karlp/wifi-advent/pics-vids/IMG_20161207_011018.jpg

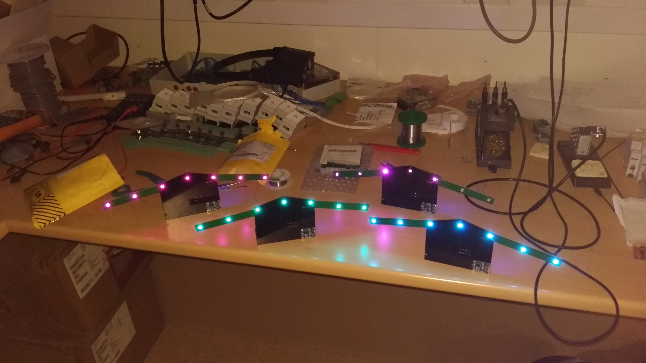
pics-vids/IMG_20161207_011018.jpg
