karlp/wifi-advent/hw/main-board-rev1d.sch

## EAGLE design hw/main-board-rev1d.sch (2016-11-26)

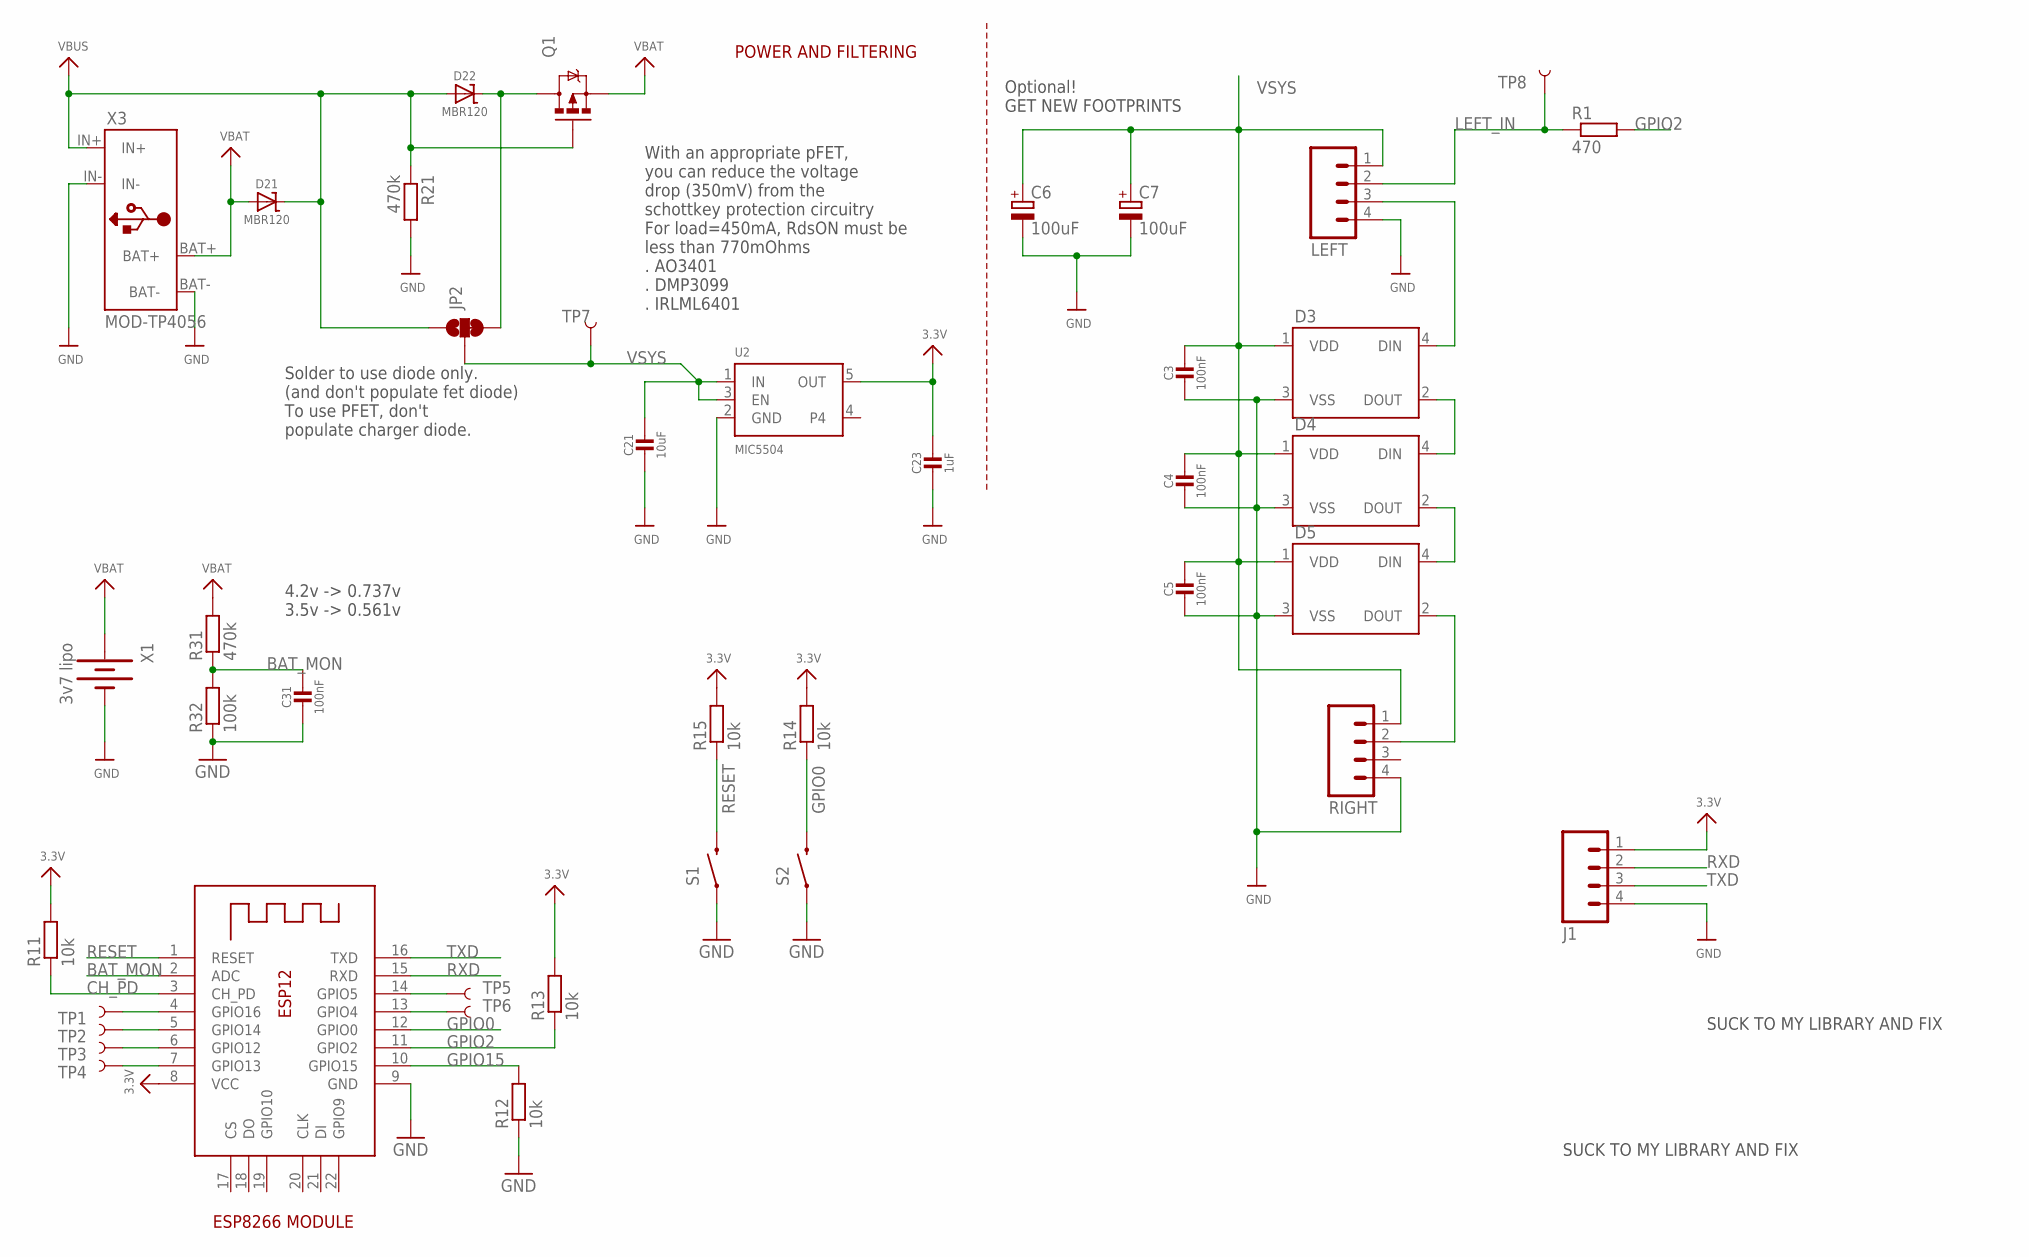
[picture p3: schematic main-board-rev1d.sch]

Parts:
C3, C4, C5, C31: 100nF; 0805-NO
C6, C7: 100uF; PANASONIC_B
C21: 10uF; 0805-NO
C23: 1uF; 0805-NO
D3, D4, D5: WS2812B
D21, D22: MBR120; SOD-123
J1: M041X04_NO_SILK; 1X04_NO_SILK
JP2: JUMPER-PAD-3-2OF3_NC_BY_TRACE_LARGE; PAD-JUMPER-3-2OF3_NC_BY_TRACE_YES_SILK_LARGE
LEFT: M041X04_NO_SILK; 1X04_NO_SILK
Q1: MOSFET-PCHANNEL; SOT23-3
R1: 470; R0603
R11, R12, R13, R14, R15: 10k; R0603
R21, R31: 470k; R0603
R32: 100k; R0603
RIGHT: M041X04_NO_SILK; 1X04_NO_SILK
S1, S2: SWITCH-MOMENTARY-2PTH; TACTILE-PTH
TP1, TP2, TP3, TP4, TP5, TP6, TP7, TP8: TEST-POINTTP_06_TH; TP_06TH
U2: MIC5504; SOT23-5
X1: 3v7 lipo; BATT-18650-BLOSSOM-1
X2: ESP-12; ESP-12E
X3: MOD-TP4056; MOD-LIPO_CHARGER

Connections:
3.3V: C23.1, J1.1, R11.2, R13.2, R14.2, R15.2, U2.5 (OUT), X2.8 (VCC)
BAT_MON: C31.1, R31.1, R32.2, X2.2 (ADC)
CH_PD: R11.1, X2.3 (CH_PD)
D3_IN: D3.4 (DIN), LEFT.3
D4_IN: D3.2 (DOUT), D4.4 (DIN)
D5_IN: D4.2 (DOUT), D5.4 (DIN)
GND: C3.2, C4.2, C5.2, C6.-, C7.-, C21.2, C23.2, C31.2, D3.3 (VSS), D4.3 (VSS), D5.3 (VSS), J1.4, LEFT.4, R12.1, R21.2, R32.1, RIGHT.4, S1.1, S2.1, U2.2 (GND), X1.-, X2.9 (GND), X3.BAT-, X3.IN-
GPIO0: R14.1, S2.3 (2), X2.12 (GPIO0)
GPIO2: R1.2, R13.1, X2.11 (GPIO2)
GPIO15: R12.2, X2.10 (GPIO15)
LEFT_IN: LEFT.2, R1.1, TP8.P$1
unnamed: TP1.P$1, X2.4 (GPIO16)
unnamed: TP2.P$1, X2.5 (GPIO14)
unnamed: D22.C, JP2.3, Q1.3 (D)
unnamed: TP3.P$1, X2.6 (GPIO12)
unnamed: TP4.P$1, X2.7 (GPIO13)
unnamed: TP5.P$1, X2.14 (GPIO5)
unnamed: TP6.P$1, X2.13 (GPIO4)
RESET: R15.1, S1.3 (2), X2.1 (RESET)
RIGHT_IN: D5.2 (DOUT), RIGHT.2
RXD: J1.2, X2.15 (RXD)
TXD: J1.3, X2.16 (TXD)
VBAT: D21.A, Q1.2 (S), R31.2, X1.+, X3.BAT+
VBUS: D21.C, D22.A, JP2.1, Q1.1 (G), R21.1, X3.IN+
VSYS: C3.1, C4.1, C5.1, C6.+, C7.+, C21.1, D3.1 (VDD), D4.1 (VDD), D5.1 (VDD), JP2.2, LEFT.1, RIGHT.1, TP7.P$1, U2.1 (IN), U2.3 (EN)

Notes on the sheet:
POWER AND FILTERING
ESP8266 MODULE
Optional! GET NEW FOOTPRINTS
4.2v -> 0.737v 3.5v -> 0.561v
With an appropriate pFET, you can reduce the voltage drop (350mV) from the schottkey protection circuitry For load=450mA, RdsON must be less than 770mOhms . AO3401 . DMP3099 . IRLML6401
Solder to use diode only. (and don't populate fet diode) To use PFET, don't populate charger diode.
SUCK TO MY LIBRARY AND FIX
