karlp/wifi-advent/hw/wifi-advent-wings.sch

## EAGLE design hw/wifi-advent-wings.sch (2016-10-18)

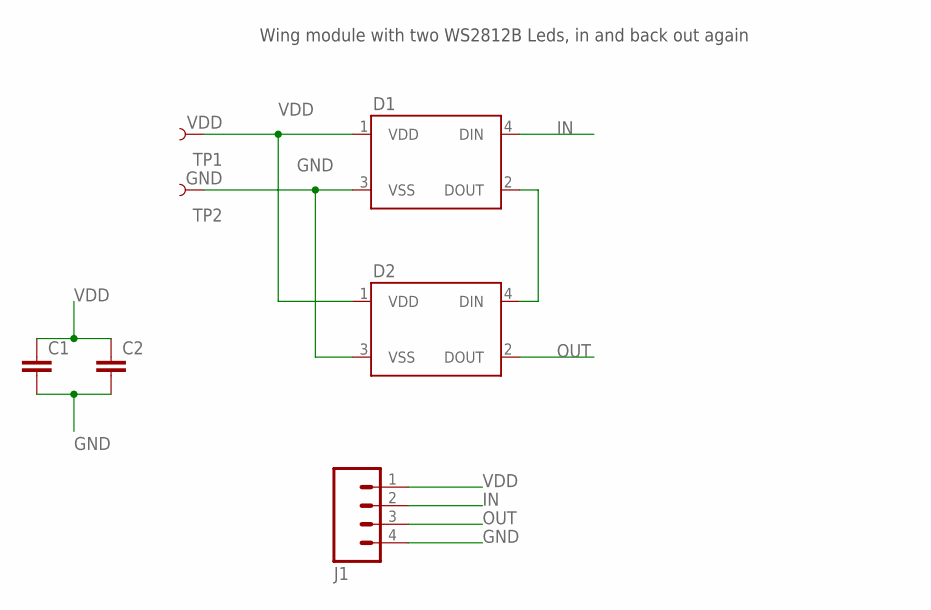
[picture p4: schematic wifi-advent-wings.sch]

Parts:
C1, C2: CAP0805; 0805
D1, D2: WS2812B
J1: M041X04_NO_SILK; 1X04_NO_SILK
TP1: VDD; PAD.03X.03
TP2: GND; PAD.03X.03

Connections:
GND: C1.2, C2.2, D1.3 (VSS), D2.3 (VSS), J1.4, TP2.P$1
IN: D1.4 (DIN), J1.2
unnamed: D1.2 (DOUT), D2.4 (DIN)
OUT: D2.2 (DOUT), J1.3
VDD: C1.1, C2.1, D1.1 (VDD), D2.1 (VDD), J1.1, TP1.P$1

Notes on the sheet:
Wing module with two WS2812B Leds, in and back out again
