karlp/wifi-advent/hw/2021-simple/2021-simple.kicad_sch

## KiCad design hw/2021-simple/2021-simple.kicad_sch (2021-11-29)

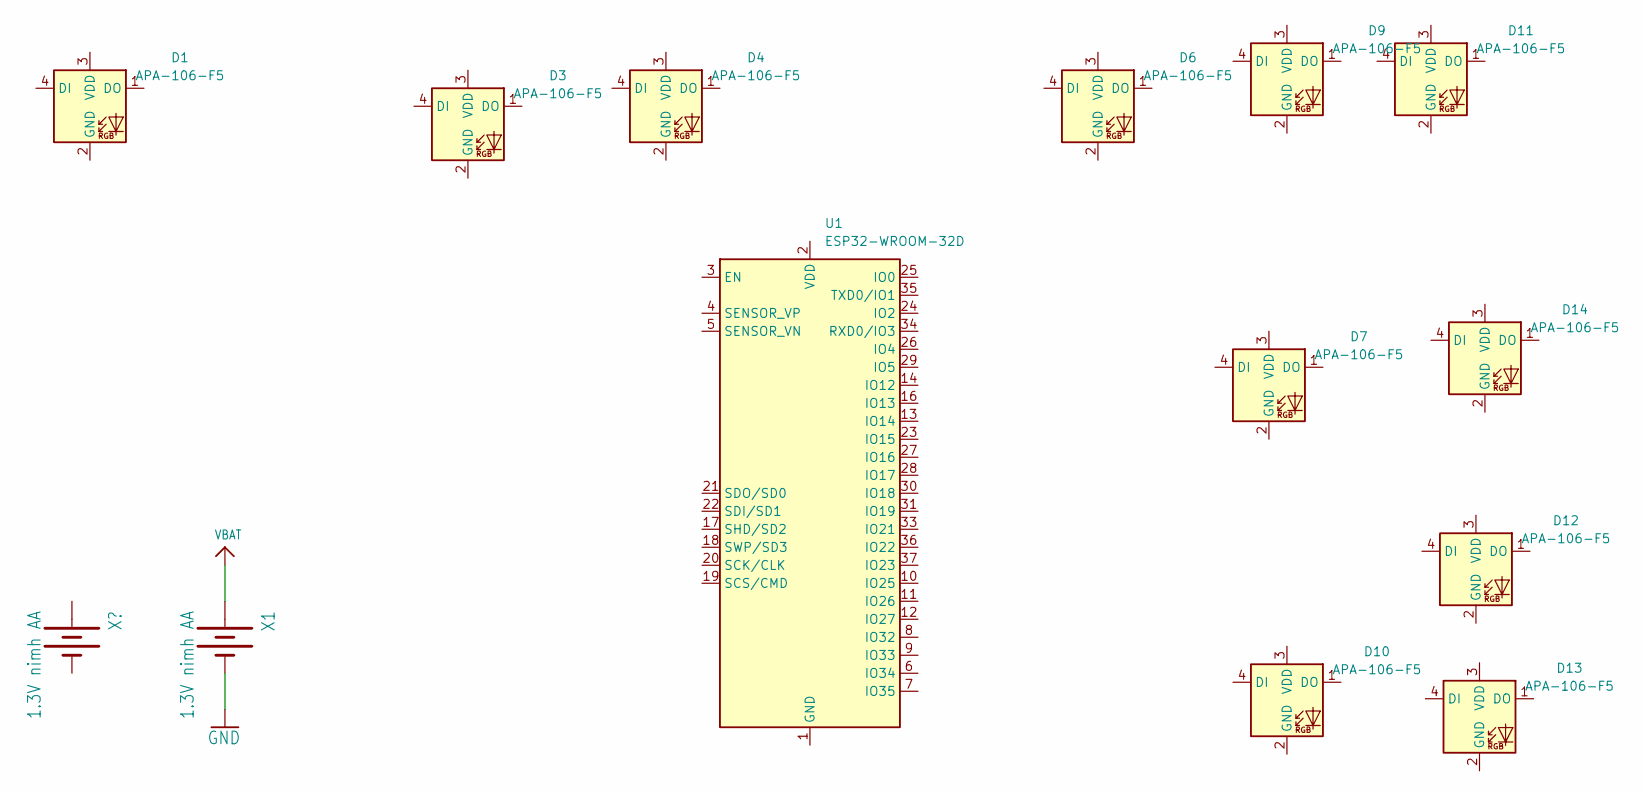
[picture p5: schematic 2021-simple.kicad_sch]

Parts:
D1, D3, D4, D6, D7, D9, D10, D11, D12, D13, D14: APA-106-F5; LED_D5.0mm-4_RGB
U1: ESP32-WROOM-32D; ESP32-WROOM-32
X1: 1.3V nimh AA; BatteryHolder_Keystone_2460_1xAA

Connections:
GND: X1.-
unnamed: U1.1 (GND), U1.15 (GND), U1.38 (GND), U1.39 (GND)
VBAT: X1.+
