karlp/wifi-advent/fw/pio1/src/main.cpp

// Karl Palsson,
// Nov 2016
// Gross basic start at OTA+leds.
// missing: AP end user setup!
#include <FS.h>
#include <ArduinoJson.h>
#include <ESP8266WiFi.h>
// Reach into the SDK for a few things not exposed by arduino land
extern "C" {
#include "sha1/sha1.h"
#include "user_interface.h"
}

#include <GDBStub.h>
#include <WiFiClient.h>
#include <ESP8266WebServer.h>
#include <ESP8266mDNS.h>
#include <ESP8266HTTPUpdateServer.h>
#include <NeoPixelBus.h>
#include <NeoPixelAnimator.h>
#include <WiFiManager_async.h>
#include <Ticker.h>
#include <AsyncMqttClient.h>

const uint16_t PixelCount = 7;
const uint8_t PixelPin = 2; // make sure to set this to the correct pin, ignored for Esp8266

// This is the pin we have wired up. (works with both nodemcu+arduino codebases)
NeoPixelBus<NeoGrbFeature, NeoEsp8266Uart800KbpsMethod> strip(PixelCount, PixelPin);

//NeoPixelAnimator animations(PixelCount, NEO_CENTISECONDS);
NeoPixelAnimator animations(PixelCount, NEO_MILLISECONDS);

uint16_t effectState = 0; // general purpose variable used to store effect state

// Nasty globals!
int id = ESP.getChipId();
String host = String("advent-" + String(id, HEX));
// isn't copied!
String mqttWillTopic = "advent/" + host + "/w";

//char _host_c[40];

const char* update_path = "/firmware";
const char* update_username = "...";
const char* update_password = "...";
char mqtt_host[60] = "...";
char mqtt_port[6] = "1883";
WiFiManagerParameter custom_mqtt_server("server", "mqtt host", mqtt_host, sizeof (mqtt_host));
WiFiManagerParameter custom_mqtt_port("port", "mqtt port", mqtt_port, sizeof (mqtt_port));

AsyncMqttClient mqttClient;
ESP8266WebServer httpServer(80);
ESP8266HTTPUpdateServer httpUpdater(true);
WiFiManager_async wifiManager;

Ticker ledDriver;
Ticker mqttReconnectDriver;

struct app_state {
    bool updatesInProgress;
    uint32_t lastReport_battery;
    int mode;
};

struct app_state state;

struct ledBlinkerState {
    int count;
    Ticker *ticker;
};

struct ledBlinkerState ledBlinker;

void tickLedBootup(int i)
{
    strip.RotateLeft(1);
    strip.Show();
}

void tickLedBlinker(struct ledBlinkerState *state)
{
    if (state->count % 2) {
        strip.SetPixelColor(0, RgbColor(0, 0, 0));
        strip.SetPixelColor(1, RgbColor(40, 40, 0));
    } else {
        strip.SetPixelColor(0, RgbColor(0, 40, 40));
        strip.SetPixelColor(1, RgbColor(0, 0, 0));
    }
    strip.Show();
    state->count--;
    if (state->count <= 0) {
        state->ticker->detach();
    }
}

void tickLedBlinkerError(struct ledBlinkerState *state)
{
    if (state->count % 3 == 0) {
        strip.SetPixelColor(0, RgbColor(40, 0, 0));
        strip.SetPixelColor(1, RgbColor(0, 0, 0));
        strip.SetPixelColor(2, RgbColor(0, 0, 0));
    } else if (state->count % 2 == 0) {
        strip.SetPixelColor(0, RgbColor(20, 0, 0));
        strip.SetPixelColor(1, RgbColor(40, 0, 0));
        strip.SetPixelColor(2, RgbColor(00, 0, 0));
    } else {
        strip.SetPixelColor(0, RgbColor(0, 0, 0));
        strip.SetPixelColor(1, RgbColor(20, 0, 0));
        strip.SetPixelColor(2, RgbColor(40, 0, 0));
    }
    strip.Show();
    state->count--;
    if (state->count <= 0) {
        state->ticker->detach();
    }
}

/**
 * hash the serial number a few times to get a durable, but not entirely
 * predictable key.
 * @param hash needs space for 20 bytes!
 */
void setup_password(unsigned char *hash)
{
    SHA1_CTX ctx;
    SHA1Init(&ctx);
    SHA1Update(&ctx, (uint8_t*) host.c_str(), host.length());
    SHA1Update(&ctx, (uint8_t*) host.c_str(), host.length());
    SHA1Update(&ctx, (uint8_t*) host.c_str(), host.length());
    SHA1Update(&ctx, (uint8_t*) host.c_str(), host.length());
    SHA1Final((unsigned char*) hash, &ctx);
}


// what is stored for state is specific to the need, in this case, the colors.
// basically what ever you need inside the animation update function
#if 0

struct MyAnimationState {
    RgbColor StartingColor;
    RgbColor EndingColor;
};

// one entry per pixel to match the animation timing manager
MyAnimationState animationState[AnimationChannels];

void SetRandomSeed()
{
}

// simple blend function

void BlendAnimUpdate(const AnimationParam& param)
{
    // this gets called for each animation on every time step
    // progress will start at 0.0 and end at 1.0
    // we use the blend function on the RgbColor to mix
    // color based on the progress given to us in the animation
    RgbColor updatedColor = RgbColor::LinearBlend(
            animationState[param.index].StartingColor,
            animationState[param.index].EndingColor,
            param.progress);

    // apply the color to the strip
    for (uint16_t pixel = 0; pixel < PixelCount; pixel++) {
        strip.SetPixelColor(pixel, updatedColor);
    }
}

void LoopAnimUpdate(const AnimationParam& param)
{
    //Serial.printf("anim: %f\n", param.progress);
    if (int(param.progress * 1000) % 30 == 0) {
        strip.RotateRight(1);
    }
}

void FadeInFadeOutRinseRepeat(float luminance)
{
    if (effectState == 0) {
        // Fade upto a random color
        // we use HslColor object as it allows us to easily pick a hue
        // with the same saturation and luminance so the colors picked
        // will have similiar overall brightness
        RgbColor target = HslColor(random(360) / 360.0f, 1.0f, luminance);
        uint16_t time = random(800, 2000);

        animationState[0].StartingColor = strip.GetPixelColor(0);
        animationState[0].EndingColor = target;

        animations.StartAnimation(0, time, BlendAnimUpdate);
    } else if (effectState == 1) {
        // fade to black
        uint16_t time = random(600, 700);

        animationState[0].StartingColor = strip.GetPixelColor(0);
        animationState[0].EndingColor = RgbColor(0);

        animations.StartAnimation(0, time, BlendAnimUpdate);
    } else if (effectState == 2) {
        int batt = analogRead(A0);
        Serial.printf("'Battery' adc = %d\n", batt);

        String topicBase = "advent/" + host + "/s";
        String tb = topicBase + "/batt";
        mqttClient.publish(tb.c_str(), 0, false, String(batt).c_str());

        // Pick a random colour, and a few versions of it...
        RgbColor col = HslColor(random(360) / 360.0f, 1.0f, luminance);
        strip.ClearTo(RgbColor(0));
        strip.SetPixelColor(0, col);

        animations.StartAnimation(0, 2000, LoopAnimUpdate);
    }

    // toggle to the next effect state
    effectState = (effectState + 1) % 3;
}
#endif

void cbWiFiEvent(WiFiEvent_t event)
{
    Serial.printf("[WiFi-event] event: %d\n", event);

    switch (event) {
    case WIFI_EVENT_STAMODE_GOT_IP:
        Serial.println("WiFi connected");
        Serial.println("IP address: ");
        Serial.println(WiFi.localIP());
        break;
    case WIFI_EVENT_STAMODE_DISCONNECTED:
        Serial.println("WiFi lost connection");
        break;
    case WIFI_EVENT_STAMODE_CONNECTED:
        Serial.println("event stamode connected");
        break;
    case WIFI_EVENT_STAMODE_AUTHMODE_CHANGE:
        Serial.println("event stamode auth changed");
        break;
    case WIFI_EVENT_STAMODE_DHCP_TIMEOUT:
        Serial.println("stamode dhcp timeout");
        break;
    case WIFI_EVENT_SOFTAPMODE_STACONNECTED:
        Serial.println("softap staconn");
        break;
    case WIFI_EVENT_SOFTAPMODE_STADISCONNECTED:
        Serial.println("softap disconn");
        break;
    case WIFI_EVENT_SOFTAPMODE_PROBEREQRECVED:
        Serial.println("softap probreq");
        break;
    }
}

void setup_dump_device()
{
    uint32_t realSize = ESP.getFlashChipRealSize();
    uint32_t ideSize = ESP.getFlashChipSize();
    FlashMode_t ideMode = ESP.getFlashChipMode();

    Serial.printf("Flash real id:   %08X\n", ESP.getFlashChipId());
    Serial.printf("Flash real size: %u\n\n", realSize);

    Serial.printf("Flash ide  size: %u\n", ideSize);
    Serial.printf("Flash ide speed: %u\n", ESP.getFlashChipSpeed());
    Serial.printf("Flash ide mode:  %s\n", (ideMode == FM_QIO ? "QIO" : ideMode == FM_QOUT ? "QOUT" : ideMode == FM_DIO ? "DIO" : ideMode == FM_DOUT ? "DOUT" : "UNKNOWN"));

    if (ideSize != realSize) {
        Serial.println("Flash Chip configuration wrong!\n");
    } else {
        Serial.println("Flash Chip configuration ok.\n");
    }

    Serial.print("CoreVersion: " + ESP.getCoreVersion() + " bootv: ");
    Serial.println(ESP.getBootVersion());

    Serial.printf("SDK Version: %s\n", ESP.getSdkVersion());

}

void wifi_scan()
{
    // WiFi.scanNetworks will return the number of networks found
    int n = WiFi.scanNetworks();
    Serial.println("scan done");
    if (n == 0)
        Serial.println("no networks found");
    else {
        Serial.print(n);
        Serial.println(" networks found");
        for (int i = 0; i < n; ++i) {
            // Print SSID and RSSI for each network found
            Serial.print(i + 1);
            Serial.print(": ");
            Serial.print(WiFi.SSID(i));
            Serial.print(" (");
            Serial.print(WiFi.RSSI(i));
            Serial.print(")");
            Serial.println((WiFi.encryptionType(i) == ENC_TYPE_NONE) ? " " : "*");
            delay(10);
        }
    }
    Serial.println("");

}

void ota_onStart()
{
    state.updatesInProgress = true;
    mqttClient.disconnect();
    Serial.println("Starting Update");
    strip.ClearTo(RgbColor(0));
    strip.SetPixelColor(0, RgbColor(0, 0, 30));
    strip.SetPixelColor(1, RgbColor(0, 0, 60));
    strip.SetPixelColor(2, RgbColor(0, 0, 120));
    strip.SetPixelColor(3, RgbColor(0, 0, 60));
}

void ota_onEnd()
{
    Serial.println("Update Finished!");
    for (int i = 0; i < 10; i++) {
        strip.ClearTo(RgbColor(0, 40, 0));
        strip.Show();
        delay(50);
        strip.ClearTo(RgbColor(0));
        strip.Show();
        delay(25);
    }
}

void ota_onError(int i)
{
    Serial.println(">>>OTA Failed?"); // FIXME - decode error!
    //    for (int i = 0; i < 10; i++) {
    //        strip.ClearTo(RgbColor(40, 0, 0));
    //        strip.Show();
    //        delay(25);
    //        strip.ClearTo(RgbColor(0));
    //        strip.Show();
    //        delay(25);
    //    }
    //    ESP.restart();
}

void ota_onProgress(unsigned int i, unsigned int j)
{
    Serial.printf("OTA Progress: %d/%d\n", i, j);
    strip.RotateRight(1);
    strip.Show();
}

/**
 * Entered on failed wifi conn or no config
 */
void handle_config_enter(WiFiManager_async *myWiFiManager)
{
    // BLink leds green?
    Serial.print("config enter (failed to autoconnect): APIP: ");
    Serial.println(WiFi.softAPIP());
    Serial.print("SSID (portal): ");
    Serial.println(myWiFiManager->getConfigPortalSSID());
    // FIXME - add ticker with new colour/speed instead of rotating green
}

bool shouldSaveConfig;

void handle_config_save(void)
{
    Serial.println("Should save config (got connected)");
    shouldSaveConfig = true;
}

/// FIXME - make this use nice objects instead of global chars!

int load_config()
{
    if (!SPIFFS.exists("/config.json")) {
        return -1;
    }
    //file exists, reading and loading
    Serial.println("reading config file");
    File configFile = SPIFFS.open("/config.json", "r");
    if (!configFile) {
        return -2;
    }
    size_t size = configFile.size();
    Serial.printf("opened config file of size: %d\n", size);
    // Allocate a buffer to store contents of the file.
    std::unique_ptr<char[] > buf(new char[size]);

    configFile.readBytes(buf.get(), size);
    DynamicJsonBuffer jsonBuffer;
    JsonObject& json = jsonBuffer.parseObject(buf.get());
    json.printTo(Serial);
    if (json.success()) {
        Serial.println("\nparsed json");
        if (json.containsKey("mqtt_server")) {
            // fallback
            strcpy(mqtt_host, json["mqtt_server"]);
        }
        if (json.containsKey("mqtt_host")) {
            strcpy(mqtt_host, json["mqtt_host"]);
        }
        if (json.containsKey("mqtt_port")) {
            strcpy(mqtt_port, json["mqtt_port"]);
        }
        if (json.containsKey("pattern")) {
            state.mode = String(json["pattern"].asString()).toInt();
        }
    } else {
        Serial.println("failed to load json config");
        return -3;
    }
    return 0;
}

int saveJson(JsonObject &json)
{
    File configFile = SPIFFS.open("/config.json", "w");
    if (!configFile) {
        Serial.println("failed to open config file for writing");
        return -1;
    }

    Serial.print("JS: saving: ");
    json.printTo(Serial);
    json.printTo(configFile);
    configFile.close();
    load_config();
    return 0;
}

int save_config()
{
    DynamicJsonBuffer jsonBuffer;
    JsonObject& json = jsonBuffer.createObject();
    json["mqtt_host"] = mqtt_host;
    json["mqtt_port"] = mqtt_port;
    saveJson(json);
    return 0;
}

void onMqttConnect(bool sessionPresent)
{
    Serial.printf("MQTT: connected: %d\n", sessionPresent);
    mqttReconnectDriver.detach();
    String t = "advent/" + host + "/c";
    uint16_t packetIdSub = mqttClient.subscribe(t.c_str(), 0);
    mqttClient.publish(mqttWillTopic.c_str(), 0, false, "ON");
}

static void mqttReconnectHandler(void)
{
    Serial.println("MQTT: Attempting reconn");
    mqttClient.connect();
}

void onMqttDisconnect(AsyncMqttClientDisconnectReason reason)
{
    // FIXME - get a useful handler abstraction for blinking leds for status
    if (state.updatesInProgress) {
        Serial.println("MQTT: disconn with update in progress, ignoring");
        return;
    }
    Serial.printf("MQTT: (unexpected) disconn: %d\n", reason);
    ledBlinker.count = 10;
    ledBlinker.ticker = &ledDriver;
    ledDriver.attach_ms(100, tickLedBlinkerError, &ledBlinker);
    // hey, probably don'ty do this immediately!
    mqttReconnectDriver.once_ms(15000, mqttReconnectHandler);
}

void onMqttMessage(char* topic, char* payload, AsyncMqttClientMessageProperties properties, size_t len, size_t index, size_t total)
{
    Serial.printf("MQTT: got msg on topic: %s\n", topic);
    // TODO - decode json, either treat as raw set commands, or mode switches to saved patterns
    // or commands like "add allowing this unit to communicate me and all that good jazz
    ledBlinker.count = 10;
    ledBlinker.ticker = &ledDriver;
    ledDriver.attach_ms(150, tickLedBlinker, &ledBlinker);
}

void setup_eus(ESP8266WebServer &ws)
{
    Serial.println("(Re)initializing EUS");
    wifiManager.setDebugOutput(true);
    wifiManager.setSaveConfigCallback(handle_config_save);
    wifiManager.setAPCallback(handle_config_enter);

    // The extra parameters to be configured (can be either global or just in the setup)
    // After connecting, parameter.getValue() will get you the configured value
    // id/name placeholder/prompt default length
    wifiManager.addParameter(&custom_mqtt_server);
    wifiManager.addParameter(&custom_mqtt_port);

    // Only for testing, throws out everything
    //wifiManager.resetSettings();
    // FIXME - make this use a random seed to generate and save to config?
    unsigned char password[20];
    setup_password(password);
    String key = "";
    for (int i = 0; i < 4; i++) {
        key += String(password[i], HEX);
    }
    Serial.printf("key=%s\n", key.c_str());
    Serial.println("Starting portal async!");
    wifiManager.startConfigPortal_async(host.c_str(), key.c_str(), &ws);
}

/**
 * Check config, if the user has configured a wifi network to join,
 * start a process that tries periodically to connect to it.
 * If not, run as a protected AP.  webserver pages are the same regardless.
 */
void setup_networking(void)
{
#if 0
    WiFi.printDiag(Serial);
    WiFi.onEvent(cbWiFiEvent);
    wl_status_t st = WiFi.begin();
    Serial.printf("ok, wifi begin returned: %d\n", st);
    // uym, ok, that might be enough?


    bool has_config = false;
    if (has_config) {
        Serial.println("FIXME - unimplemented!");
        panic();
    }
    WiFi.persistent(true);
    WiFi.mode(WIFI_AP_STA);

    unsigned char dhash[20];
    setup_password(dhash);
    String key = "";
    for (int i = 0; i < 4; i++) {
        key += String(dhash[i], HEX);
    }
    Serial.printf("key=%s\n", key.c_str());
    WiFi.softAP(host.c_str(), key.c_str());
    IPAddress myIP = WiFi.softAPIP();
    Serial.print("AP IP address: ");
    Serial.println(myIP);
#endif
}

void setup_ota(ESP8266WebServer &ws)
{

    httpUpdater.onStart(ota_onStart);
    httpUpdater.onEnd(ota_onEnd);
    httpUpdater.onError(ota_onError);
    httpUpdater.onProgress(ota_onProgress);

    httpUpdater.setup(&ws, update_path, update_username, update_password);
    ws.begin();

    bool mdnsok = MDNS.begin(host.c_str());
    if (mdnsok) {
        Serial.println("mdns began ok, registering service");
        MDNS.addService("http", "tcp", 80);
    } else {
        Serial.println(">> MDNS begin failed!");
    }

    Serial.printf("HTTPUpdateServer ready! Open http://%s.local%s in your browser and login with username '%s' and password '%s'\n", host.c_str(), update_path, update_username, update_password);
    Serial.println("(Local) IP address: ");
    Serial.println(WiFi.localIP());
    Serial.println("(If AP) IP address: ");
    Serial.println(WiFi.softAPIP());
}

String getContentType(String filename)
{
    if (httpServer.hasArg("download")) return "application/octet-stream";
    else if (filename.endsWith(".htm")) return "text/html";
    else if (filename.endsWith(".html")) return "text/html";
    else if (filename.endsWith(".css")) return "text/css";
    else if (filename.endsWith(".js")) return "application/javascript";
    else if (filename.endsWith(".png")) return "image/png";
    else if (filename.endsWith(".gif")) return "image/gif";
    else if (filename.endsWith(".jpg")) return "image/jpeg";
    else if (filename.endsWith(".ico")) return "image/x-icon";
    else if (filename.endsWith(".xml")) return "text/xml";
    else if (filename.endsWith(".pdf")) return "application/x-pdf";
    else if (filename.endsWith(".zip")) return "application/x-zip";
    else if (filename.endsWith(".gz")) return "application/x-gzip";
    return "text/plain";
}

bool handleFileRead(String path)
{
    Serial.print("handleFileRead: " + path);
    if (path.endsWith("/")) path += "index.htm";
    String contentType = getContentType(path);
    String pathWithGz = path + ".gz";
    if (SPIFFS.exists(pathWithGz) || SPIFFS.exists(path)) {
        if (SPIFFS.exists(pathWithGz))
            path += ".gz";
        File file = SPIFFS.open(path, "r");
        size_t sent = httpServer.streamFile(file, contentType);
        file.close();
        Serial.println("->OK");
        return true;
    }
    Serial.println("->FAIL");
    return false;
}

void setup_webserver(void)
{
    httpServer.onNotFound([]() {
        if (!handleFileRead(httpServer.uri()))
            httpServer.send(404, "text/plain", "FileNotFound");
    });
    httpServer.on("/advent", [&]() {
        File file = SPIFFS.open("/index.htm", "r");
        size_t sent = httpServer.streamFile(file, "text/html");
        file.close();
        return true;
    });
    httpServer.on("/forget", [&]() {
        Serial.println("delete config and reboot?");
        // FIXME - delete any json config too?
        // We need to be storing saved led prefs too!
        httpServer.send(200, "application/json", R"({"msg": "forget went ok"})");
        system_restore();
        ESP.restart();

    });
    httpServer.on("/j/config", HTTP_GET, [&]() {
        Serial.println("WEB: Loading j/config");
        File file = SPIFFS.open("/config.json", "r");
        if (file.size() > 0) {
            size_t sent = httpServer.streamFile(file, "application/json");
        } else {
            httpServer.send(200, "application/json", "{}");
        }
        file.close();
        return true;
    });
    httpServer.on("/j/config", HTTP_POST, [&]() {
        Serial.println("WEB: saving j/config");
        DynamicJsonBuffer newBuffer;
        JsonObject& newjson = newBuffer.parseObject(httpServer.arg("plain"));
        saveJson(newjson);
        httpServer.send(200, "application/json", R"({"msg": "ok"})");
    });
    Serial.println("Finished plain webserver setup");
}

void setup_mqtt()
{
    mqttClient.onConnect(onMqttConnect);
    mqttClient.onDisconnect(onMqttDisconnect);
    mqttClient.onMessage(onMqttMessage);
    mqttClient.setServer(mqtt_host, String(mqtt_port).toInt());
    mqttClient.setKeepAlive(60).setCleanSession(true);
    mqttClient.setClientId(host.c_str());
    mqttClient.setWill(mqttWillTopic.c_str(), 1, true, "OFF");
    Serial.println("Connecting to MQTT...");
    mqttClient.connect();
}

void setup()
{
    Serial.begin(115200);
    Serial.println("Booting Sketch...");
    //strcpy(_host_c, host.c_str());
    // stable, and at least unique per device.
    randomSeed(id);
    strip.Begin();
    strip.Show();
    strip.SetPixelColor(0, RgbColor(0, 40, 0));
    ledDriver.attach_ms(250, tickLedBootup, 0);
    if (SPIFFS.begin()) {
        Serial.println("mounted file system");
        load_config();
    } else {
        Serial.println("failed to mount FS");
    }

    setup_dump_device();
    Serial.print("Reset reason and info: ");
    Serial.println(ESP.getResetReason());
    Serial.println(ESP.getResetInfo());

    WiFi.onEvent(cbWiFiEvent);

    setup_eus(httpServer);
    setup_ota(httpServer);
    setup_mqtt();

    setup_webserver();

    ledDriver.detach();
    //pinMode(2, OUTPUT);
    Serial.println("----setup-finished----");
}

uint32_t last_minor, last_flicker;

void setup_fade(struct app_state *st)
{
    // Fade upto a random color
    // we use HslColor object as it allows us to easily pick a hue
    // with the same saturation and luminance so the colors picked
    // will have similiar overall brightness
    RgbColor start = RgbColor(0, 0, 0);
    RgbColor target = HslColor(random(360) / 360.0f, 1.0f, 0.25);
    uint16_t time = random(800, 2000);

    animations.StartAnimation(0, time, [ = ](const AnimationParam & param){
        RgbColor updatedColor = RgbColor::LinearBlend(start, target, param.progress);
        // apply the color to the strip
        for (uint16_t pixel = 0; pixel < PixelCount; pixel++) {
            strip.SetPixelColor(pixel, updatedColor);
        }
    });
}

void setup_roll(struct app_state *st)
{
    // Pick a random colour, and a few versions of it...
    RgbColor col = HslColor(random(360) / 360.0f, 1.0f, 0.25);
    strip.ClearTo(RgbColor(0));
    strip.SetPixelColor(0, col);
    uint16_t time = random(800, 2000);
    animations.StartAnimation(0, time, [ = ](const AnimationParam & param){
        if (int(param.progress * 1000) % 30 == 0) {
            strip.RotateRight(1);
        }
    });
}

// Choose a random candle to "flicker"

void setup_candle_set_flicker()
{
    int pixel = random(PixelCount);
    RgbColor originalColor = strip.GetPixelColor(pixel);
    // flame sparkle
    RgbColor targetColor = RgbColor(128 + random(20), 128, 128);
    AnimUpdateCallback animUpdate = [ = ](const AnimationParam & param){
        // too many curves!
        float progress = NeoEase::ExponentialIn(param.progress);
        // use the curve value to apply to the animation
        RgbColor updatedColor = RgbColor::LinearBlend(originalColor, targetColor, progress);
        strip.SetPixelColor(pixel, updatedColor);
    };
    animations.StartAnimation(pixel, 100 + random(100), animUpdate);
}

void setup_candle_set()
{
    // setup some animations
    for (uint16_t pixel = 0; pixel < PixelCount; pixel++) {
        // swell candles up and down a little over ~1.5 seconds
        // pick a random duration of the animation for this pixel
        // since values are centiseconds, the range is 1 - 4 seconds
        uint16_t time = random(800, 2000);

        // each animation starts with the color that was present
        RgbColor originalColor = strip.GetPixelColor(pixel);
        // and ends with a random color
        RgbColor targetColor;
        if (random(100) > 97) {
            targetColor = RgbColor(128 + random(20), 128, 128);
        } else {
            //targetColor = RgbColor(234 + random(20), 90 + random(20), 0);
            targetColor = HslColor(random(25) / 360.0f, 1.0, (35 + random(20)) / 100.0f);
        }


        // we must supply a function that will define the animation, in this example
        // we are using "lambda expression" to define the function inline, which gives
        // us an easy way to "capture" the originalColor and targetColor for the call back.
        //
        // this function will get called back when ever the animation needs to change
        // the state of the pixel, it will provide a animation progress value
        // from 0.0 (start of animation) to 1.0 (end of animation)
        //
        // we use this progress value to define how we want to animate in this case
        // we call RgbColor::LinearBlend which will return a color blended between
        // the values given, by the amount passed, hich is also a float value from 0.0-1.0.
        // then we set the color.
        //
        // There is no need for the MyAnimationState struct as the compiler takes care
        // of those details for us
        AnimUpdateCallback animUpdate = [ = ](const AnimationParam & param){
            // too many curves!
            float progress = NeoEase::ExponentialInOut(param.progress);
            // use the curve value to apply to the animation
            RgbColor updatedColor = RgbColor::LinearBlend(originalColor, targetColor, progress);
            strip.SetPixelColor(pixel, updatedColor);
        };

        // now use the animation properties we just calculated and start the animation
        // which will continue to run and call the update function until it completes
        animations.StartAnimation(pixel, time, animUpdate);
    }
}

int animCount = 0;

void loop()
{
    // handles both eus _and_ ota
    uint32_t before;

    //    before = ESP.getCycleCount();
    httpServer.handleClient();
    //    Serial.printf("handle took: %d\n", ESP.getCycleCount() - before);
    // pointless, will continually repoll after finished?

    //    before = ESP.getCycleCount();
    bool eusv = wifiManager.loop();
    if (eusv) {
        Serial.printf("wifi loop finished!\n");
        // manager gave up or succeeded
        bool up = wifiManager.endConfigPortal_async();
        if (up) {
            Serial.println("EUS COMPLETE! we're now a station!");
        } else {
            // Means that EUS failed to connect to the requested server.
            // no biggie, but should probably provide a button press to restart if desired?
            Serial.println("EUS gave up!");
            //setup_eus(httpServer);
        }
    }

    if (shouldSaveConfig) {
        shouldSaveConfig = false;
        Serial.println("Reached loop, need to save config!");
        Serial.printf("MQ details: %s:%s\n", custom_mqtt_server.getValue(), custom_mqtt_port.getValue());
        strcpy(mqtt_host, custom_mqtt_server.getValue());
        strcpy(mqtt_port, custom_mqtt_port.getValue());
        save_config();
    }

    //    Serial.printf("eus shit took: %d\n", ESP.getCycleCount() - before);
    yield();
    if (millis() - state.lastReport_battery > 15000) {
        int batt = analogRead(A0);
        Serial.printf("Battery adc = %d\n", batt);
        String topicBase = "advent/" + host + "/s";
        String tb = topicBase + "/batt";
        mqttClient.publish(tb.c_str(), 0, false, String(batt).c_str());
        state.lastReport_battery = millis();
    }


    if (!ledDriver.active()) {
        if (animations.IsAnimating()) {
            // the normal loop just needs these two to run the active animations
            before = ESP.getCycleCount();
            animations.UpdateAnimations();
            strip.Show();
            //            Serial.printf("anim took: %d\n", ESP.getCycleCount() - before);
        } else {
            Serial.printf("led: next set: %d\n", state.mode);
            switch (state.mode) {
            case 1:
                setup_fade(&state);
                break;
            case 2:
                setup_roll(&state);
                break;
            default:
            case 0:
                animCount++;
                // example function that sets up some animations
                if (animCount % 3 == 0) {
                    setup_candle_set_flicker();
                } else {
                    setup_candle_set();
                }
                break;

            }
        }
    }
}
