karlp/wifi-advent/(commit log)

2016-10-18 wings: intial pcb
    Should have had this from the beginning, but ok.
    [wifi-advent-wings.brd, wifi-advent-wings.sch]
2016-10-18 central board: "initial" schematic/board
    Board is unrouted, but leds are placed and fixed.
    Schematic is _provisionally_ complete.
    [draft4-modular-split.brd, draft4-modular-split.sch]
2016-10-18 notes on which pins can control leds with existing libraries
2016-10-18 basic test that the leds all work.
2016-10-18 gerbmerge files for wings layout
    [gerbmerge-layout.cfg]
2016-10-19 library: add blossom 18650 single battery holder
2016-10-20 updates listed below
    * used blossom battery case
    * switched to 100uF big fat smds for "bulk" ws2812 support
    * fixed values for vbat monitoring divider and added cap to hold it
    [draft4-modular-split.brd, draft4-modular-split.sch]
2016-10-25 Routed all basic signals
    Going to hold here and use all that space to put in the pfet+diode
    method as well as just optional footprints.
    only get one build
    [draft4-modular-split.brd]
2016-10-25 added optional pfet+diode power path instead of diode
    fully routed, corrected error with (non)rotated wings.
    [draft4-modular-split.brd, draft4-modular-split.sch]
2016-10-25 add polygon for vbat
    [draft4-modular-split.brd]
2016-10-25 make all caps consistent footprints
    split VSYS into two forks to distribute power better. even at 1mm wide,
    trace resistance is estimted at 300mOhm. (but that's for the whole
    lenght, not longest fork)
    [draft4-modular-split.brd, draft4-modular-split.sch]
2016-10-25 smash and fix all silk
    Add notes on connectors and test points
    [draft4-modular-split.brd, draft4-modular-split.sch]
2016-10-25 remove duplicate wires on optional caps
    stupid schematic capture
    [draft4-modular-split.brd, draft4-modular-split.sch]
2016-10-25 Align buttons
    [draft4-modular-split.sch]
2016-10-25 remove superfluous cutout for usb
    [draft4-modular-split.brd]
2016-10-25 Add revision and author text
    [draft4-modular-split.brd]
2016-10-26 Pull ground back from antenna
    [draft4-modular-split.brd]
2016-10-28 push hw files down a level
    [draft4-modular-split.brd, draft4-modular-split.sch, gerbmerge-layout.cfg, wifi-advent-wings.brd, wifi-advent-wings.sch]
2016-11-13 fw: Basic arduino ota+leds
    massive missing holes already. but progress is progress
    [combo-ota1.ino]
2016-11-13 Add esp8266 arduino as submodule
    we're going to need to fix upstream :(
2016-11-15 neat fet solution
2016-11-18 fw: platformio version1
    A little easier to build and work with than the arduino IDE, but
    virutally identical to the "ard/combo-ota1" sketch.
    Uses my own fork of arduino with the OTA callbacks added (submitted
    upstream already)
2016-11-18 pio1: whitespace autoformat
    carryover from bringing this pile over from arduino ide
2016-11-22 pio: set led count for dev board
    We can go back to 7 when we have real hardware
2016-11-22 pio: fix leds in OTA update + basic mqtt
    Should be split in two, bad karl!
    leds were missing strip.Show()! The animation handler was fixing that
    internally, but is required if you're fiddling yourself. Other commands
    are only updating the internal states.
    MQTT publishing seems to work, but it crashes in the onMessageHandler
    for some reason.
    [main.cpp]
2016-11-26 emergency rev1d draft
    stupid polygon rank screwup. I _know_ I handled this, but somewhere it
    got lost and reset, and the final gerbers had all the polys joined again
    :(
    seeing as we're redoing, put notches for the wings, allows both flush
    with wire and through hole mounts.
    Also, move the esp8266 module to the board edge to give the antenna a
    better shot.
    [main-board-rev1d.brd, main-board-rev1d.sch]
2016-11-26 tp4056 module: make fit modules received better
    Original sourced from the internet _worked_ but the pins were a bit
    skewed.
    Changes: expand drills, reduce pads.
2016-11-26 battery: blossom: use slightly more sane drills
    Based on the received hardware. the 2.4mm drill specified in the
    datasheet is way pessimistic. The datasheet was spot on for the pins on
    the device, no idea why they were so pessimistic for the pcb pattern.
2016-11-26 hw rev 1.2
    Moved module to side for "proper" rf.
    Fixed rotated wing connectors
    Fixed overlapping polygon pours
    Relaid out almost all of the lower section
    Added more test points, and all spare ios on ESPmodule
    [main-board-rev1d.brd, main-board-rev1d.sch]
2016-11-26 lib: add test points
    Originall from sparkfun, but with a through hole one modified to 0.6mm
    drill which matches basic vias, that I can stuff cat5 strands into in a
    pinch.
2016-11-28 pio: add missing arduinojson dep
2016-12-01 See changelist
    Ticker for led handling so that mqtt messages don't crash.
    Private ticker class (pull request sent) to enable easy "still active"
    checking
    File handling and basic default files for spiffs
    Needs: uploader support for spiffs image.
    [main.cpp]
2016-12-05 blink leds via ticker for mqtt
    Same as before, avoids panic when the disconnect hits
    [main.cpp]
2016-12-05 Drop MQTT: not used, some problems
    Will come back, but wills are failing, and initial target won't have
    wifi anyway, nor is the mqtt infrastructure ready.
    [main.cpp]
2016-12-07 pio: final led count for real hw now
2016-12-08 properly block mqtt when we're updating.
    reconnection attempts were crashing it.
    [main.cpp]
2016-12-09 Vile hacky bootstrap
    too many static files, nowhere near clever enough at using client side
    resources!
    my js/html foo is too weak to knock this out quickly!
    [main.cpp]
2016-12-09 Basic support for setting led patterns via web.
    no ui, json config only
2016-12-09 mqtt: fix will
    Because async mqtt is _fulllllly_ async, it doesn't actually copy/store
    the will topic and use it when you call connect, it jsut fires off the
    tcp connect and tries to use the will when that actually finishes.
    However, at that time, the dynamic will String had gone out of scope,
    and so was considered invalid => no will.
    Use a global for now. Wills now work at least.
    [main.cpp]
2016-12-09 fix json reply to clients
    [main.cpp]
2018-01-05 hw1: notes after assembling rev1
2021-11-29 hw: Initial stab of new gen single pcb
    through hole diffused leds and esp32 instead.
    [2021-simple.kicad_pcb, 2021-simple.kicad_sch]
