karlp/wifi-advent/(notices)

Notices in the files:
hw/draft4-modular-split.sch:
COPYRIGHT: 2016
parts and their libraries:
microbuilder: This work is placed in the public domain, and may be freely used for commercial and non-commercial work with the following conditions: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
SparkFun-Connectors: Licensing: Creative Commons ShareAlike 4.0 International - https://creativecommons.org/licenses/by-sa/4.0
